lukelookluck/naraebar/backend/drf-yasg공부.md

[drf-yasg](https://medium.com/towncompany-engineering/%EC%B9%9C%EC%A0%88%ED%95%98%EA%B2%8C-django-rest-framework-api-%EB%AC%B8%EC%84%9C-%EC%9E%90%EB%8F%99%ED%99%94%ED%95%98%EA%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)
