lukelookluck/naraebar/requirement.md

- Local

  - 음료 선택 페이지
  - 완료
  - 실패 

- mobile web

  - 사용자 인증
  - 마이페이지 (내 기기 관리 & 즐겨찾기 레시피 확인)
  - 커뮤니티 (레시피 공유)

- 임베디드 

  - 펌프로 액상끌어올리기 (깔떼기통해서 내보내기)
  - 라즈베리파이 포트 수 확인하고
  - 펌프 받으면 제어 잘되는지 확인하기 
  - 펌프 확인해보기 라즈베리파이 포트 수 확인해보기
