lukelookluck/naraebar/릴리즈 노트.md

릴리즈 노트

NaReBar

-  v1.0.0 (Bata)
- 20 Aug 2020

개요

- 나만의 칵테일 레시피로 음료를 만들고 공유할 수 있는 모바일 커뮤니티 및 가정용 칵테일 제조기기 

목적

- 모바일
  - 나만의 레시피를 등록할 수 있다.
  - 등록된 레시피가 커뮤니티에 공유되어, 다른 사람의 레시피도 확인할 수 있다.
  - 커뮤니티에 존재하는 다른 사람의 레시피를 저장하거나 좋아요하고 댓글을 남길 수 있다.
- 디바이스
  - 서버로부터 받아온 레시피 정보를 확인할 수 있다.
  - 해당 레시피 제조 버튼을 눌러서 정량대로 칵테일을 제조할 수 있다. 
  - 세척 버튼을 눌러서 사용 후 잔여물이 남지 않도록 관리할 수 있다. 

연락 정보

- hongsj36@gmail.com

| 작성항목 | 설 명 |
| --- | --- |
| Header | 문서 이름(릴리스 노트 이름), 제품 이름, 버전 번호, 릴리즈 날짜, 참고 날짜, 노트 버전 등 |
| 개요 | 제품 및 변경에 대한 간략한 전반적 개요 |
| 목적 | 릴리스 버전의 새로운 기능목록과 릴리스 노트의 목적에 대한 간략한 개요. 버그 수정 및 새로운 기능 기술. |
| 이슈 요약 | 버그의 간단한 설명 또는 릴리즈 추가 항목 요약 |
| 재현 항목 | 버그 발견에 따른 재현 단계 기술 |
| 수정/개선 내용 | 수정 / 개선의 간단한 설명 기술 |
| 사용자 영향도  | 버전 변경에 따른 최종 사용자 기준의 기능 및 응용 프로그램 상의 영향도 기술 |
| SW 지원 영향도 | 버전 변경에 따른 SW의 지원 프로세스 및 영향도 기술 |
| 노트 | SW 및 HW Install 항목, 제품, 문서를 포함한 업그레이드 항목 메모 |
| 면책 조항 | 회사 및 표준 제품과 관련된 메시지.프리웨어, 불법 복제 방지, 중복 등 참조에 대한 고지 사항 |
| 연락 정보 | 사용자 지원 및 문의 관련한 연락처 정보 |
