lukelookluck/naraebar/예산안.md

## 예산안

| 상품 | 모델명 | 구매링크 | 단가 | 개수(ea) | 합계 | 구매 여부  |
| --- | --- | --- | :--- | --- | --- | --- |
| 다이아프램 펌프 | Micro diaphragm Pump (60W) | [다이아프램 펌프](http://itempage3.auction.co.kr/DetailView.aspx?ItemNo=B505533012&frm3=V2) | 19,200원 ( + 배송비: 2,500원) | 1 | 21,700 | 완료 |
| 릴레이모듈 (8ch) | 8ch Serial Module | [릴레이모듈](http://itempage3.auction.co.kr/DetailView.aspx?ItemNo=B505595214&frm3=V2) | 4,650원 (다이아프램 펌프와 같이 구매 ) | 1 | 4,650 | 완료 |
| 파워서플라이(12V출력) | LRS-150-12 | [파워서플라이](https://smartstore.naver.com/jooyontns/products/498834333) | 28,500원 ( + 배송비: 2,500원) | 1 | 31,000 | 완료 |
| 우레탄 호스 12(외경)*8(내경) 1m | Urethane hose | [pvc호스](https://smartstore.naver.com/saytool/products/3864976067) | 890원 (원터치피팅 pc와 같이 구매) | 1 | 890 | 완료 |
| 우레탄 호스 8(외경)*5(내경) 1m | Urethane hose | [pvc호스](https://smartstore.naver.com/saytool/products/3864976067) | 690원 (원터치피팅 pt와 같이 구매) | 4 | 2,760 | 완료 |
| 원터치피팅 pc: 호스 연결 | PC08-02 | [원터치피팅 pc](https://smartstore.naver.com/saytool/products/3864976067) | 630원 ( + 배송비:  2,500원) | N+1 | 5,650 | 완료 (5개) |
| 원터치피팅 pt: 호스 연결 (t자 연결) | PT08-02 | [원터치 피팅 pt](https://www.devicemart.co.kr/goods/view?no=12284384) | 1,650원 ( + 배송비: 2,500원) | N | 9,100 | 완료 (4개) |
| 원터치피팅 pcf: 유량계 연결 (8) | PCF08-04 | [원터치피팅 pcf8](https://smartstore.naver.com/saytool/products/3864976067) | 2,200원 (원터치피팅 pt와 같이 구매) | 1 | 2,200 | 완료 |
| 원터치피팅 pcf: 유량계 연결 (12) | PCF12-04 | [원터치피팅 pcf12](https://smartstore.naver.com/saytool/products/3864976067) | 2,540원 (원터치피팅 pt와 같이 구매) | 1 | 2,540 | 완료 |
| 모터드라이버 | L298 | [모터드라이버](https://www.devicemart.co.kr/goods/view?no=1278835) | 2,200원 ( + 배송비: 2,500원) | 1 | 4,700 | 완료 |
| 솔레노이드 밸브 | 2Way-솔레노이드(8A) | [솔레노이드 밸브](https://smartstore.naver.com/washcar/products/3884691932) | 5,000원 ( + 배송비: 3,000원 * 2) | N+1 | 8,000+ 23,000 = 31,000 | 완료 (5개) |
| 다이오드 (10개) | 1N4007 | [다이오드](https://www.devicemart.co.kr/goods/view?no=3011)  | 270원 (모터드라이버와 같이 구매) | 1 | 270 | 완료 |
| 레귤레이터 (5V) 모듈 | PWR060010 | [레귤레이터 5V](https://www.devicemart.co.kr/goods/view?no=1384708) | 2,310원 (모터드라이버와 같이 구매) | 1 | 2,310 | 완료 |
| (+추가) 아두이노유량계 | YF-S201C | [유량계](https://smartstore.naver.com/makepcb/products/2075862320) | 8,200원 ( + 배송비: 2,500원) | 1 | 10,700 | 완료 |
| (+선택) LED바 | | 예산 부족 | | 1 | | |
| | | | | | | |
| | | | | 합계 | 120,470 | |

N: 액상 개수 -> 4개 

## 구매 리스트 

- ~~다이아프램 펌프 1개~~ (구매 완료)
- ~~릴레이모듈 (4ch~8ch) : 모터 제어 신호 레벨 변환 역할~~ (구매 완료)
- ~~파워서플라이 (12V출력)~~ (구매 완료)
- ~~pvc호스 12(외경)*8(내경) 1m~~  (구매 완료)
- ~~pvc 호스 8(외경)*5(내경) 4m  (구매 완료)~~
- ~~원터치피팅 pc: 호스 연결 N개~~  (구매 완료)
- ~~원터치피팅 pt: 호스 연결 (t자 연결) N개~~  (구매 완료)
- ~~원터치 피팅 PCF08-04: 유량계 연결~~   (구매 완료)
- ~~원터치 피팅 PCF12-04: 유량계 연결~~   (구매 완료)
- ~~(+선택) 원터치피팅 변환피팅: 12-8 변환피팅 1개~~  (유량계 사용해서 필요 없음)
- ~~모터드라이버 1개~~  (구매 완료)
- ~~솔레노이드 밸브 5개 (당장은 1개만 구매해서 테스트)~~   (구매 완료)
- ~~다이오드 1N4007 * 4~~  (구매 완료)
- ~~레귤레이터 (5V) 모듈~~  (구매 완료)
- ~~수수, 암수 , 암암 세종류 점퍼선~~ (싸피 키트에 포함)
- ~~테프론 테이프~~ (세진선배가 집에서 파밍함)
- ~~(+추가) 아두이노유량계~~   (구매 완료)
- ~~(+선택) LED~~ (예산부족)
- ~~(+추가) 깔떼기 Kitchen Funnel~~  (세진선배가 출력)
- 케이스
