lukelookluck/naraebar/NaReBar 기획서(0723).docx

NaReBar

나만의 레시피 바텐더 기획서

2020. 7. 22(수)

긴급구조 팀

홍세진(팀장), 유건우, 임창묵, 황신실, 이윤민

## 기획서

#### 목차

#### 1. 개요

#### 2. 구상

#### 3. 구현

#### 4. 업무 분배

#### 5. 프로젝트 일정

#### 1. 개요

프로젝트명: 나레바(나만의 레시피 바텐더)

주제: 모바일 웹을 통해 커스텀 레시피를 등록할 수 있는 홈 바텐더 기기 제작

  1-1 . 주제 선정 배경 및 시장 분석

1) 배경

‘코로나바이러스감염증-19’으로 인해 현대인들의 생활 양상에 많은 변화가 일어나고 있다. 2019 년 12월 중국 우한시에서 첫 ‘코로나바이러스감염증-19’ 이 발견된 이후 그 여파는 전 세계로 퍼져나갔다. 대한민국 정부에서는 2020년 2월 23일 감염병 위기 단계를 ‘심각’수준으로 상향했고, WHO(세계보건기구)에서도 2020년 3월 12일 해당 감염병에 대해 최고 경보단계인 펜데믹 (pandemic)을 선언하며 전 세계가 ‘코로나바이러스감염증-19’에 적극 대응하는 모습을 보이고 있다.

‘코로나바이러스감염증-19’은 기침, 재채기 등으로 인한 비말에 의해 감염되는 것으로 알려졌으며, 이에 따라 대한민국 정부에서는 사람 많은 곳 방문 자제와 마스크 착용 등의 행동 수칙을 지정했다. 뿐만 아니라 감성주점, 유흥주점, 노래 연습장 등을 고위험시설로 분류하는 등 ‘코로나바이러스감염증-19’의 확산을 막기 위한 많은 노력이 이루어지고 있다.

2) 국내 현황

‘코로나바이러스감염증-19’으로 인해 감성주점, 유흥주점, 노래 연습장 등이 고위험시설로 분류됨에 따라 집에서 혼자 술을 즐기는 이른바 ’혼술’ 문화가 주류로 자리잡고 있다.

편의점 CU에 따르면 3월의 주류 매출이 전년 대비 20% 가량 증가했고, 이마트24의 3월 와인 매출은 225.6% 신장하는 등 편의점의 주류 매출이 크게 증가했다. 업계 관계자는 “코로나19로 소비자들의 라이프스타일이 변화하면서 편의점에서는 주류 매출이 가장 두드러지게 나타나고 있다”고 언급했다.

LG전자는 이러한 흐름에 맞춰 100만원대의 캡슐형 수제 맥주 제조기를 선보이기도 했다.

코로나19에 홈술족 시장 ‘봄 바람’… 가정용 주류 소비 늘어(뉴데일리경제)

http://biz.newdaily.co.kr/site/data/html/2020/04/21/2020042100102.html

혼술족 위한 캡슐형 수제맥주제조기 나왔다. (한겨레)

http://www.hani.co.kr/arti/economy/consumer/953122.html

3) 기대 효과

칵테일을 즐기는 사람들은 많지만, 레시피를 잘 모르고 실제로 계량하여 제조하는 것이 힘들기 때문에 집에서 즐기기는 쉽지가 않다. 코로나19로 인해 사람들이 붐비는 장소에 가기 힘든 요즘, 집에 머무는 시간이 길어진 사람들은 ‘코로나 블루’라는 우울감을 느끼기도 한다.

그래서 자동으로 칵테일을 만들어주고, 자신만의 레시피를 만들어 공유할 수 있는 홈 바텐더와 모바일 웹 서비스 “나만의 레시피 바텐더(이하 나레바)”를 제안한다.

현재 존재하는 시제품 칵테일 머신은 저장된 레시피로 조합하여 칵테일을 제조한다. “나레바”는 사용자가 직접 커스텀하여 칵테일을 만들 수 있고, 자신만의 레시피를 커뮤니티에 올려 다른 사람들과 공유할 수도 있다. 이를 통해 다양한 칵테일을 맛볼 수 있고, 자신의 개성을 표출할 수 있다.

  1-2. 프로젝트 개발 방향
1) 이용 대상

20~30대 대학생 및 직장인

2) 목표
  A. 여러 술을 섞어서 제공하는 하드웨어 제작
  B. 사용자의 레시피를 입력 받는 모바일 웹 UI제작
  C. 레시피를 받아오고 공유할 수 있는 커뮤니티 서버 제작

#### 2. 구상

#### 1. 기능 명세

#### 1-1. 로컬 UI

#### 1) React로 칵테일 제조 화면 구현

#### 1-1.1.1. 대기화면

#### 1-1.1.2. 레시피 선택 화면

#### 1-1.1.3. 제조 화면

#### 1-1.1.4. 완료 화면

#### 1-2. 모바일 웹 UI

#### 1) React로 나레바 사이트 구현

#### 1-2.1.1. 메인화면

#### 1-2.1.2. 로그인 화면

#### 1-2.1.3. 커뮤니티 화면

#### 1-2.1.3.1. 나만의 레시피 등록 화면

#### 1-2.1.4. 마이페이지 화면

#### 1-2.1.4.1. 동기화 기능

#### 1-3. 서버

#### 1) 웹 서버

#### 1-3.1.1. 커뮤니티 구현

#### 2) 로컬 서버

#### 1-3.2.1. 아두이노 제어

#### 1-3.2.2. 라즈베리파이로 커뮤니티 레시피 데이터 전송

#### 1-4. 임베디드

#### 1) 수신한 데이터에 맞춰 펌프 제어

#### 1-4.1.1. 라즈베리파이와의 시리얼 통신

#### 1-4.1.2. 펌프 제어 회로 구상

#### 1-4.1.3. 펌프 제어 알고리즘 구현

#### 2) 제작 완료 정보 전송

#### 1-4.2.1. 라즈베리파이와의 시리얼 통신

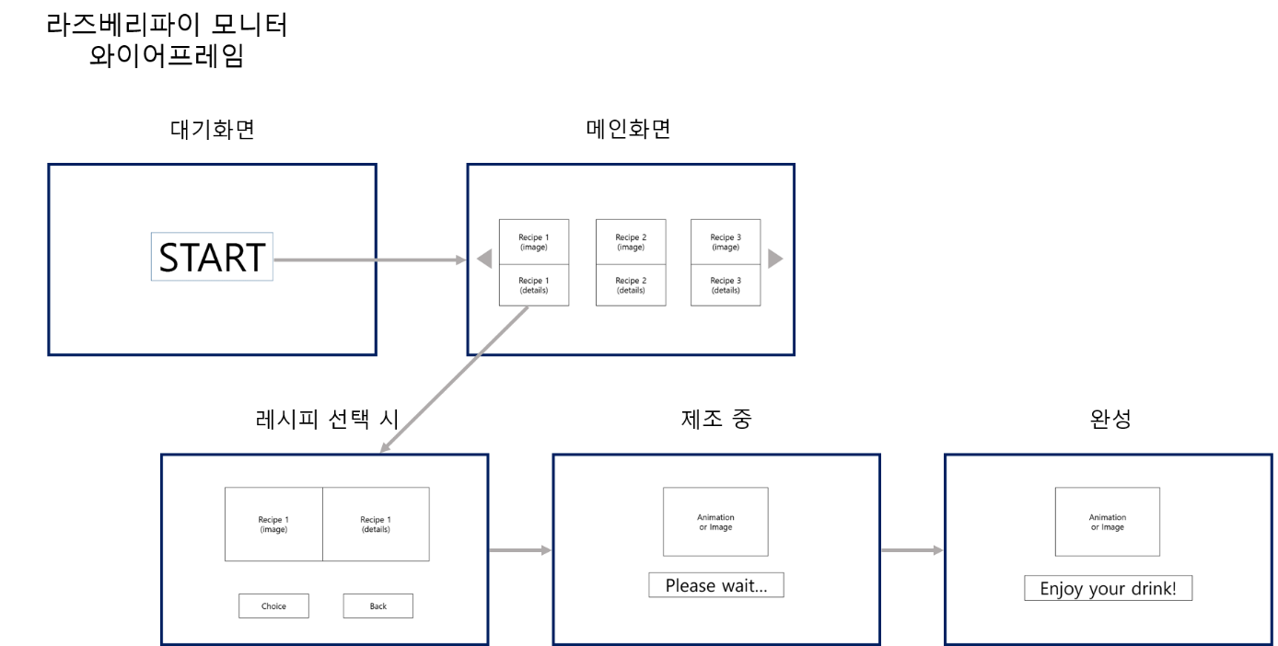
[picture p7: figure]

#### 2. 와이어프레임

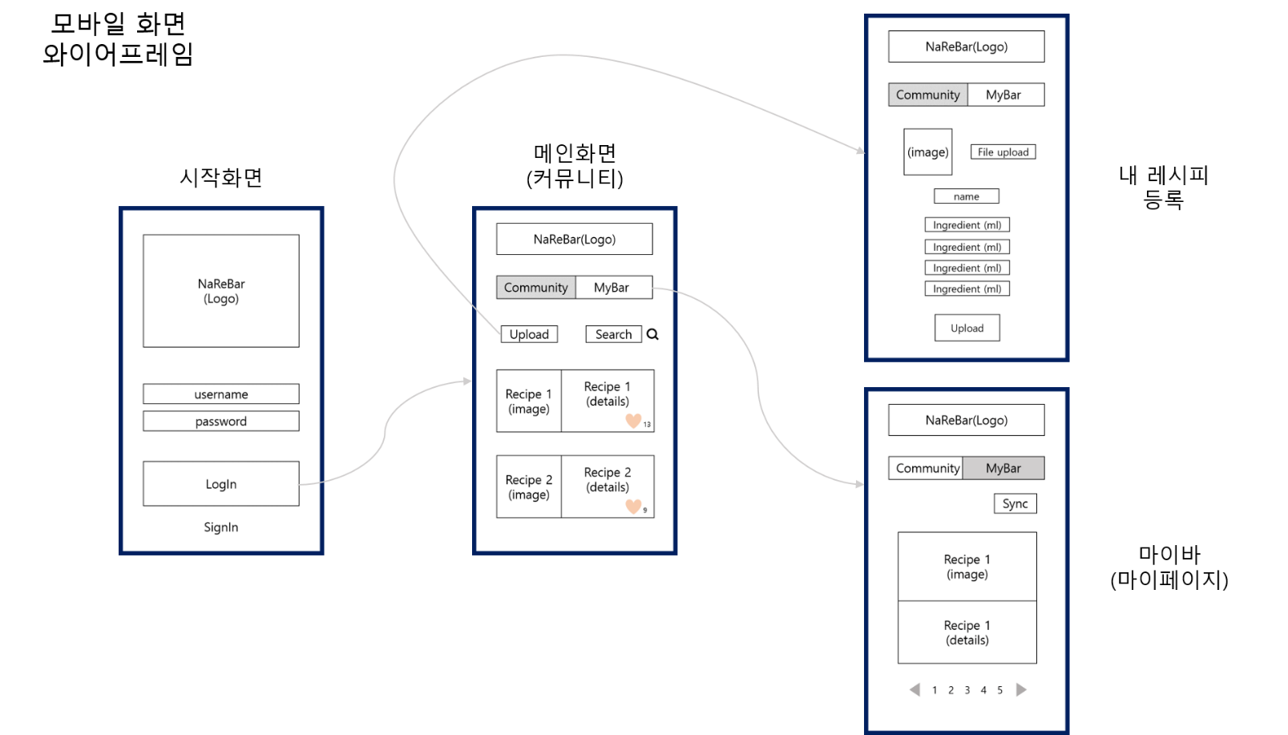
[picture p8: figure]

#### 3. API // 미완성

요청url | 데이터 형식 | 비고

#### 4. 개발 언어 및 활용 장비

항목 | 적용대상 | 비고
React | 프론트엔드
Raspberry pi LCD | 프론트엔드 | 1개 제공
Django | 백엔드
MariaDB | 백엔드
AWS | 백엔드
EC2 | 백엔드
Raspberry pi 4 | 프론트엔드, 백엔드, 임베디드 | 1개 제공
Arduino | 임베디드 | 1개 제공
Pump (DC Motor) | 임베디드 | 자비로 구매
Relay Module | 임베디드 | 자비로 구매

#### 5. 예산

항목 | 상세 | 단가 | 수량 (ea) | 비용
펌프(모터) 모델명: | 역할: 칵테일 재료를 끌어올림 링크: 펌프 (https://smartstore.naver.com/ic11401/products/697431761) | 8400 | 4 | 33600
모터드라이버 모델명: L293D | 역할: 모터 구동을 위한 드라이버 링크: 모터 드라이버 (https://smartstore.naver.com/ic11401/products/560846516) | 2040 | 1 | 2040
다이오드 모델명: 1N4007 | 역할: 역전압 보호회로 구성 링크: 다이오드 (https://www.devicemart.co.kr/goods/view?no=3011) | 25 | 8 | 200
파워서플라이 모델명: | 역할: 12V전원 공급 링크: 파워서플라이 (https://smartstore.naver.com/jooyontns/products/498258307) | 24500 | 1 | 24500
레귤레이터 모델명: LM2576T-5V | 역할: 12V전원 -> 5V전원으로 변환 링크: 레귤레이터 (https://www.devicemart.co.kr/goods/view?no=1058242) | 800 | 1 | 800
PVC 호스 | 역할: 칵테일 재료 이동 통로 링크: PVC호스 (펌프 선택구매란에 있음) (https://smartstore.naver.com/ic11401/products/697431761) | 1000 | 3 | 3000
점퍼선 (수-수,암-수,암-암) | 역할: 브레드보드 회로 결선 링크: 점프선(M/M) (https://www.devicemart.co.kr/goods/view?no=1321196), 점프선(F/M) (https://www.devicemart.co.kr/goods/view?no=1321195), 점프선(F/F) (https://www.devicemart.co.kr/goods/view?no=1321192) (종류별로 한묶음씩) | 850 | 3 | 2550
기타 | 배송료 (협신전자, 디바이스마트, 주연티앤에스) | 2500 | 3 | 7500
합계 | | | | 74190원

#### 3. 구현

#### 3-1. 기술 상세 명세 // 미완성

#### 1) 모바일 웹 UI

#### A. 메인 화면

#### 2) 로컬 UI

#### 3) 서버

#### 4) 임베디드

#### - 회로구성

#### - 부품 선정

#### - 모터 (펌프) : 액상을 펌핑하는 역할

#### - 모터드라이버 : 모터 구동을 위한 드라이버

#### - 다이오드 : 모터 보호회로에 사용

#### - 파워서플라이 (12V출력) : 12V전원 공급

#### - 레귤레이터 (5V) : 12V전원 -> 5V전원으로 변환

#### - pvc호스 : 칵테일 재료 이동 통로

#### - 점퍼선 (수-수, 암-수, 암-암) : 브레드보드 회로 결선

#### - 모터 기준으로 전력량 계산하여 적절한 소자를 구매할 것

#### - 회로도 구상

#### - 전원부

#### - 12V전원을 모터에 공급

#### - 레귤레이터를 통해 5V로 변환된 전원을 라즈베리파이와 아두이노에 각각 공급

#### - 시리얼 통신

#### - 라즈베리파이의 txd와 rxd와 아두이노의 rxd, txd를 연결

#### - 모터

#### - GPIO와 모터드라이버를 통해 모터를 제어할 수 있도록 구성

#### - 모터드라이버와 모터 사이에 다이오드를 통한 보호회로 구성

#### - 회로 결선

#### - 브레드 보드 위에 회도로 대로 결선

#### - 아두이노

#### - 펌프

#### - 모터 구동

#### - GPIO포트 및 모터드라이버를 이용해 모터 구동 코드 개발

#### - 펌프 정확도 확인

#### - 시리얼통신

#### - 컴퓨터와의 시리얼 통신 구현 코드 개발

#### - 컴퓨터와의 연결을 끊고 라즈베리파이와의 시리얼 통신 구현

#### - 라즈베리파이

#### - 파이썬으로 아두이노와의 시리얼 통신 구현

#### - 라즈베리 파이 시리얼포트 활성화

#### - 파이썬 씨리얼모듈 import하여 시리얼통신 코드 구현

#### - 아두이노와의 시리얼 통신 테스트

#### - 하드웨어 제작

#### - 펌프를 추가하여 시제품 제작

#### - 케이스 제작

#### - LCD 부착

#### 3-2. 구성도

#### - 전체 구상

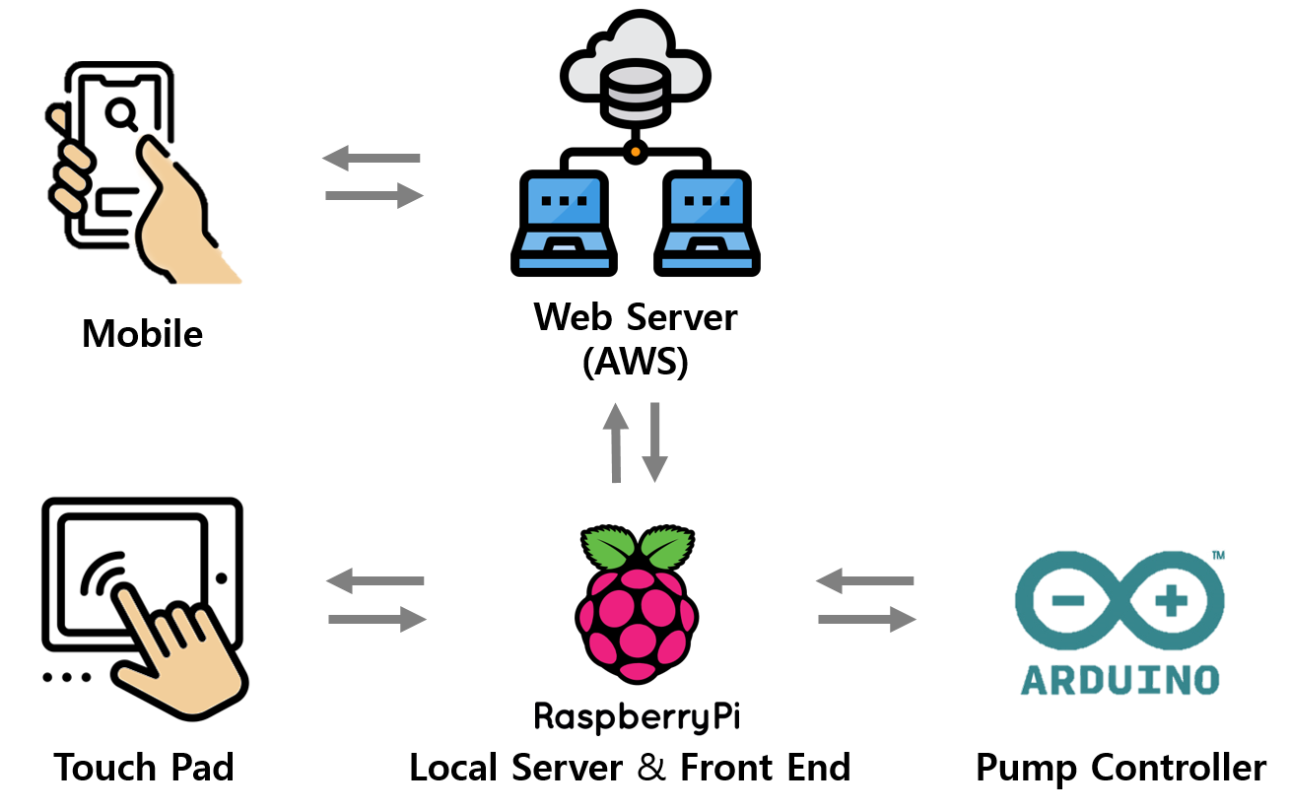
[picture p9: figure]

#### - 펌프 & 밸브

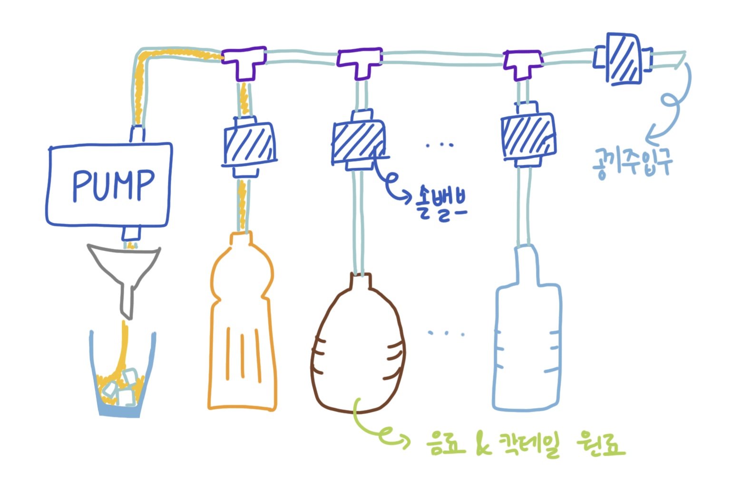
[picture p10: figure]

#### 3-3. 회로도

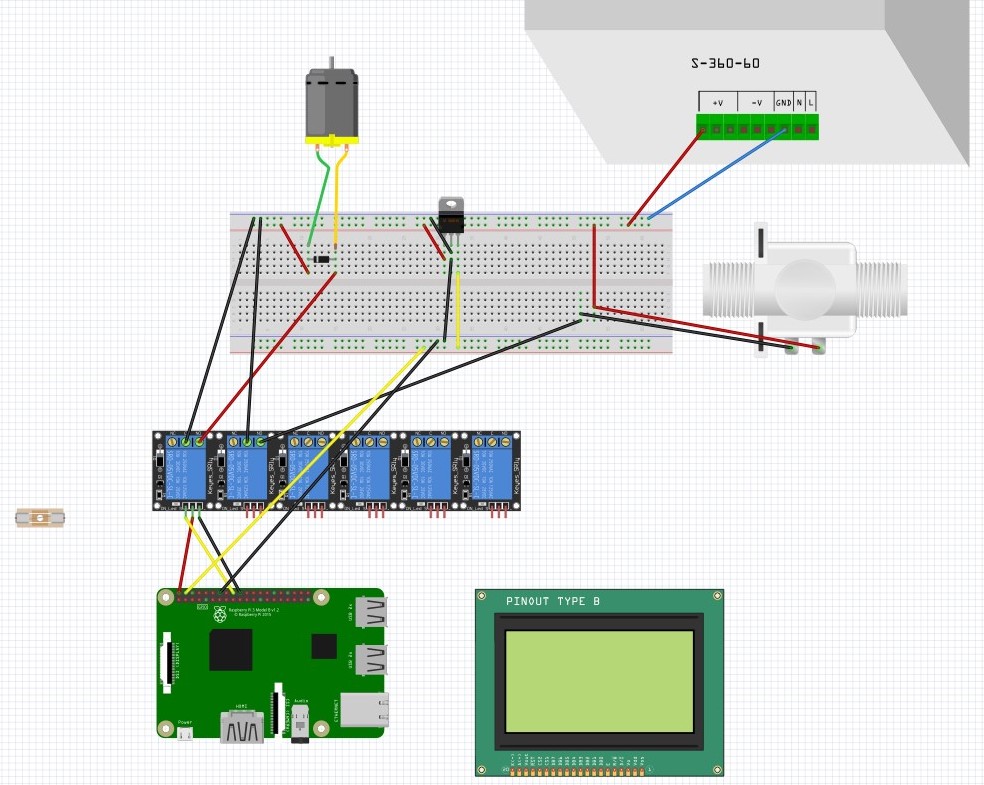
[picture p11: figure]

4. 업무 분배

- 홍세진(팀장): 백엔드, 임베디드 (라즈베리파이, 구매)

- 유건우: 프론트엔드

- 임창묵: 프론트엔드

- 황신실: 임베디드 (아두이노, 주변 회로설계)

- 이윤민: 프론트엔드

#### 5. 프로젝트 일정

#### sub_pjt2

#### - 1주차

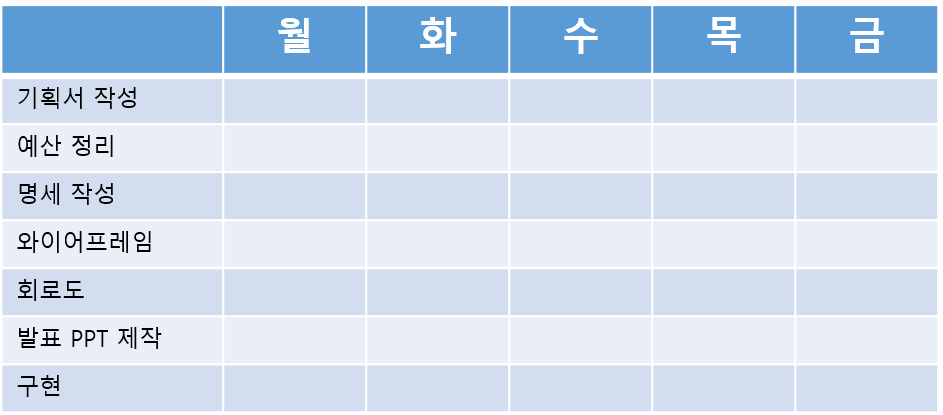
[picture p12: figure]

#### - 2주차

#### sub_pjt3

#### - 1주차

#### - 2주차

#### - 2주차

#### - 임베디드: 부품 조작 및 프로토타입 제작 완료 ( 모터 및 밸브 구동 )

#### - 프론트엔드: 와이어프레임에 맞게 로컬 및 웹 화면 구성

#### - 백엔드: 로컬 서버 구현

#### sub_pjt3 // 미완성

#### - 1주차

#### - 2주차

#### - 3주차
