lukelookluck/naraebar/나레바_로컬_화면_구상중_0721_.pptx

대기화면

START

## Slide 2

메인화면

Recipe 1
(image)

Recipe 2
(image)

Recipe 3
(image)

Recipe 1
(details)

Recipe 2
(details)

Recipe 3
(details)

## Slide 3

칵테일 선택

Recipe 1
(image)

Recipe 1
(details)

Choice

Back

## Slide 4

선택 후

Animation
or Image

Please wait…

## Slide 5

완성

Enjoy your drink!

Animation
or Image

## Slide 6

라즈베리파이 모니터
와이어프레임

대기화면

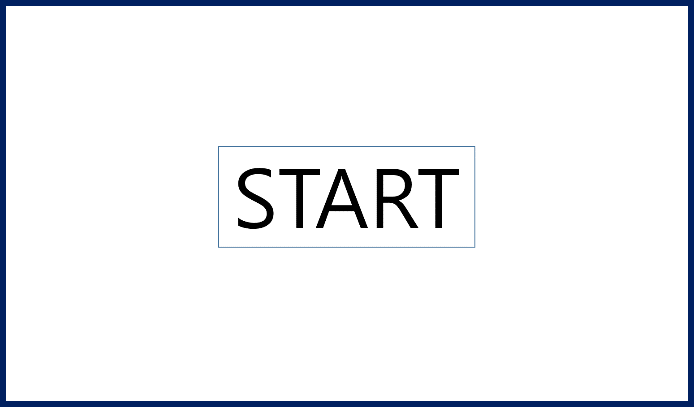
[picture p13: figure]

메인화면

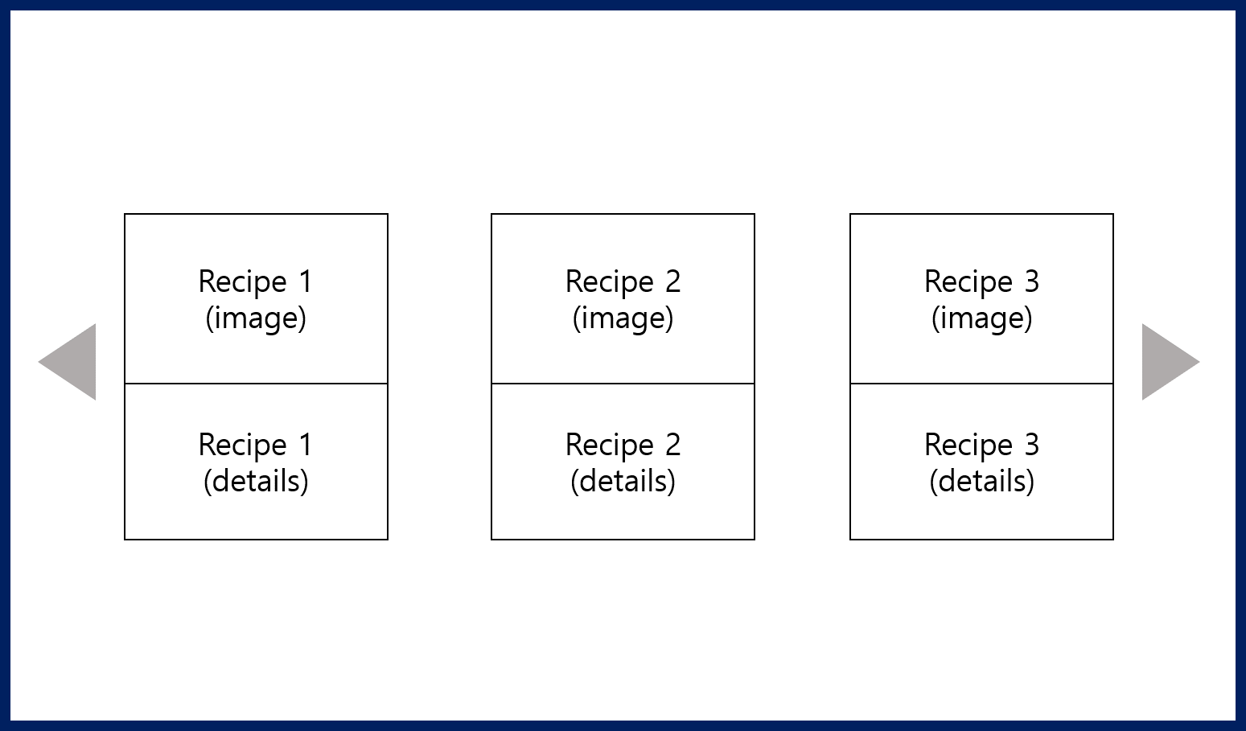
[picture p14: figure]

레시피 선택 시

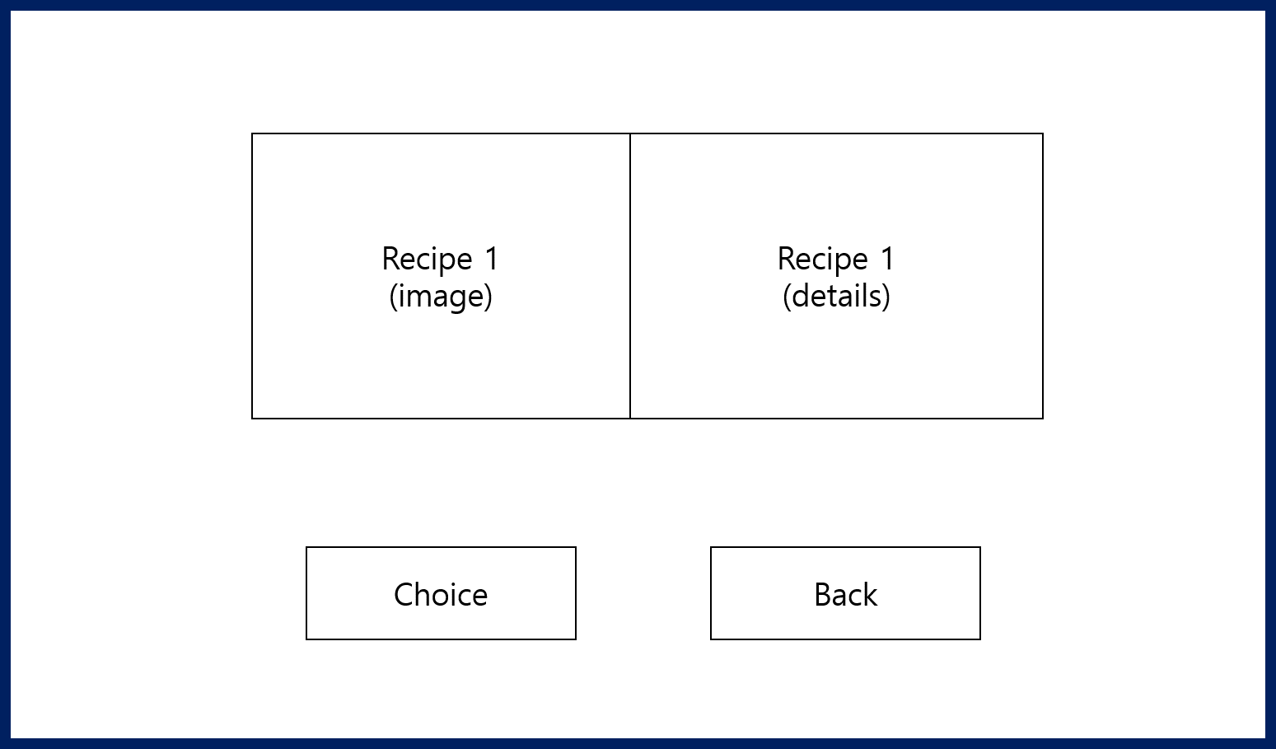
[picture p15: figure]

제조 중

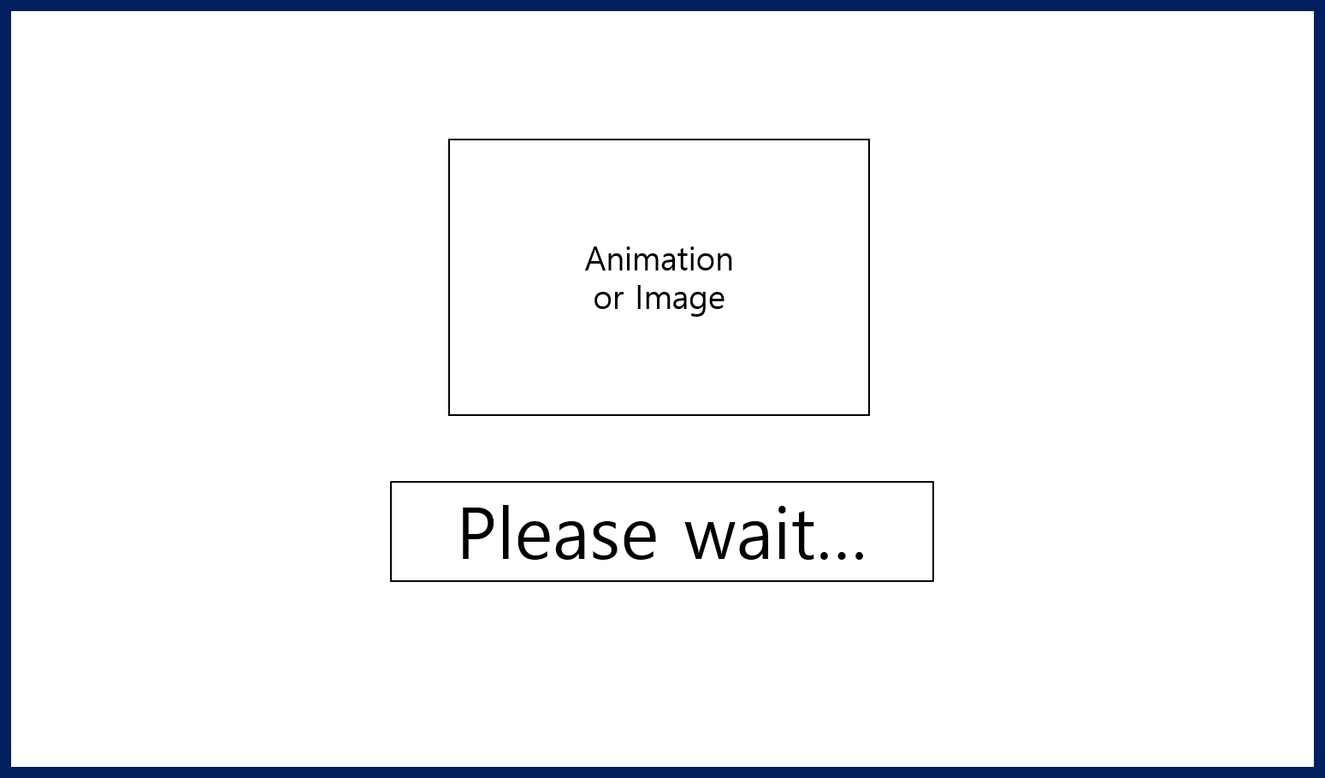
[picture p16: figure]

완성

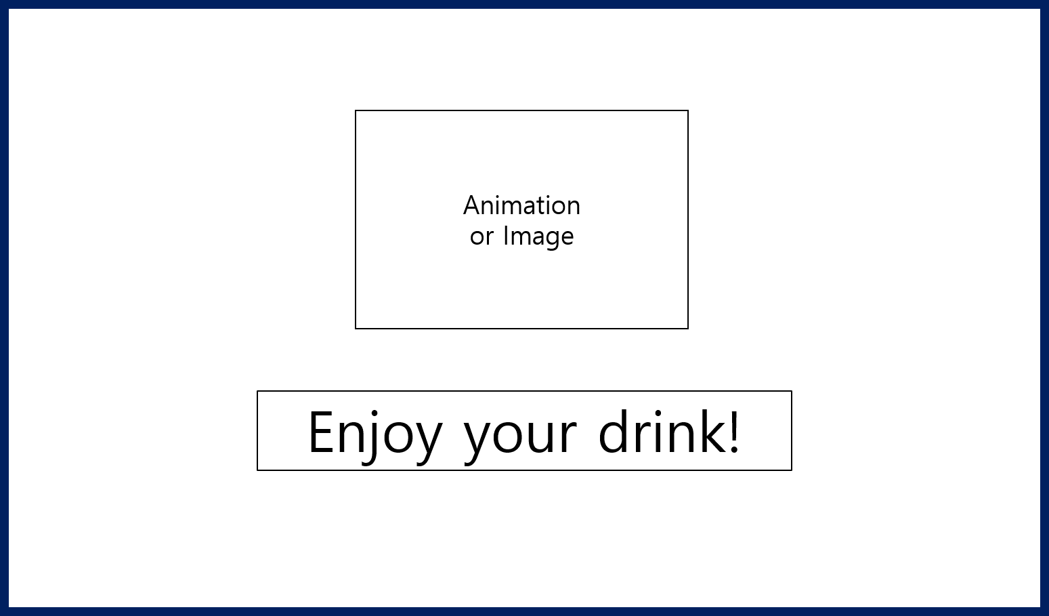
[picture p17: figure]
