lukelookluck/naraebar/나레바_모바일_화면_구상중_0721_.pptx

메인화면

NaReBar
(Logo)

username

password

LogIn

SignIn

## Slide 2

로그인후
메인화면

NaReBar(Logo)

MyBar

Community

Upload

Recipe 1
(image)

Recipe 2
(image)

Search

Recipe 1
(details)

Recipe 2
(details)

13

9

## Slide 3

로그인후
Upload 클릭 시

NaReBar(Logo)

MyBar

Community

(image)

File upload

Ingredient (ml)

name

Ingredient (ml)

Ingredient (ml)

Ingredient (ml)

Upload

## Slide 4

로그인후
MyBar

NaReBar(Logo)

MyBar

Community

Sync

Recipe 1
(image)

Recipe 1
(details)

1 2 3 4 5
