lukelookluck/naraebar/backend/web/media/2020/08/15/b2d03e59-f0f3-4398-b04f-a8fa04100514.jpg

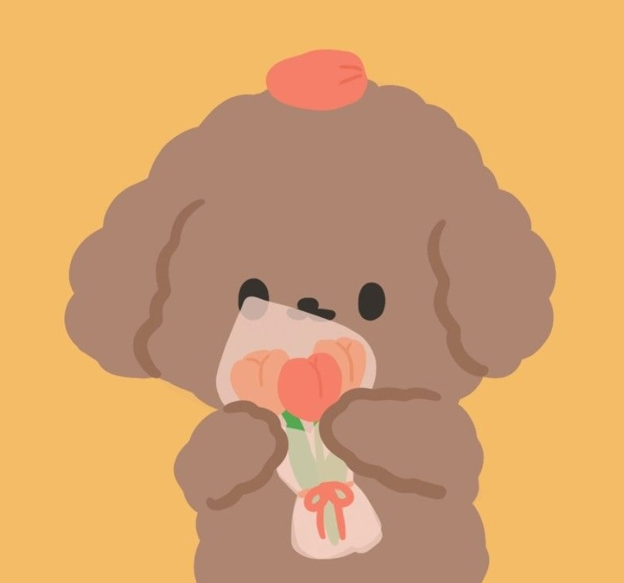
backend/web/media/2020/08/15/b2d03e59-f0f3-4398-b04f-a8fa04100514.jpg
