lukelookluck/naraebar/backend/web/media/2020/08/20/a615ee56-f529-42a6-a362-80225d327c8a.jpg

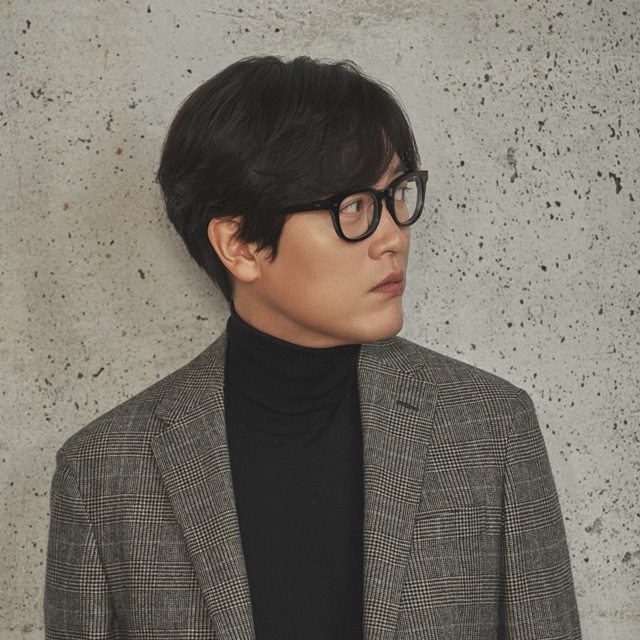
backend/web/media/2020/08/20/a615ee56-f529-42a6-a362-80225d327c8a.jpg
