lukelookluck/naraebar/backend/web/media/2020/08/20/c9f65255-5e9a-4d70-8621-e818bfa2c31f.jpg

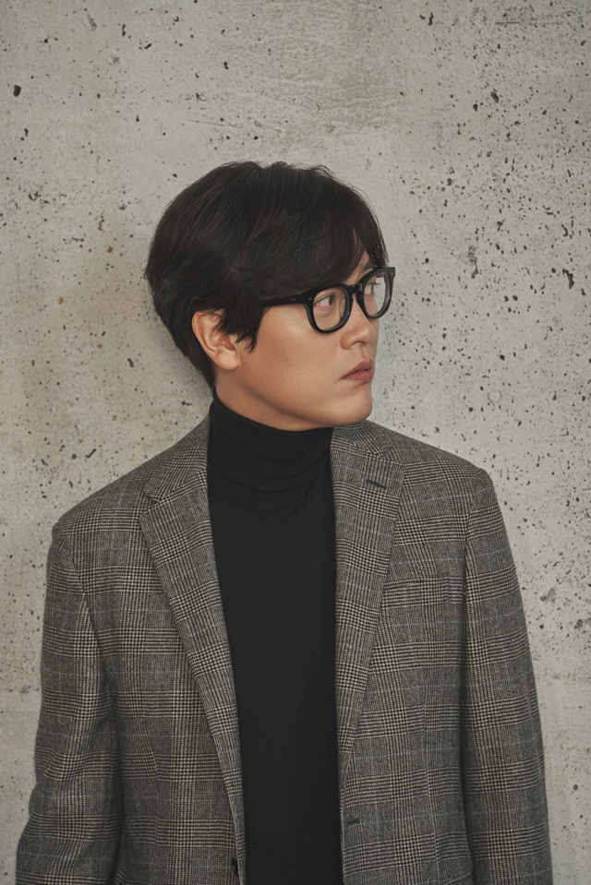
backend/web/media/2020/08/20/c9f65255-5e9a-4d70-8621-e818bfa2c31f.jpg
