lukelookluck/naraebar/images/FastPwmCom.JPG

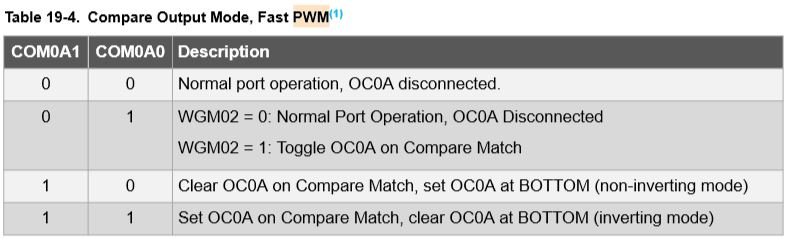
images/FastPwmCom.JPG
