lukelookluck/naraebar/images/idea1.jpg

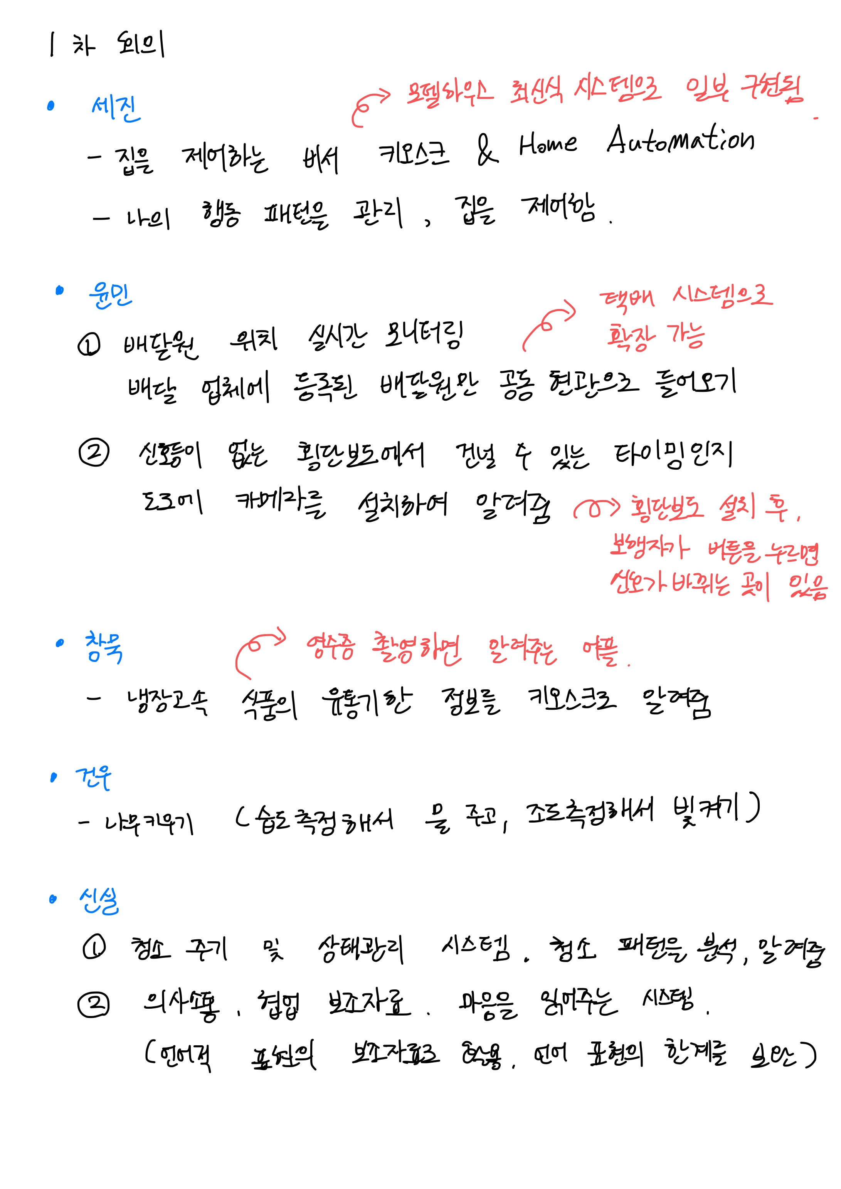
images/idea1.jpg
