lukelookluck/naraebar/images/idea2.jpg

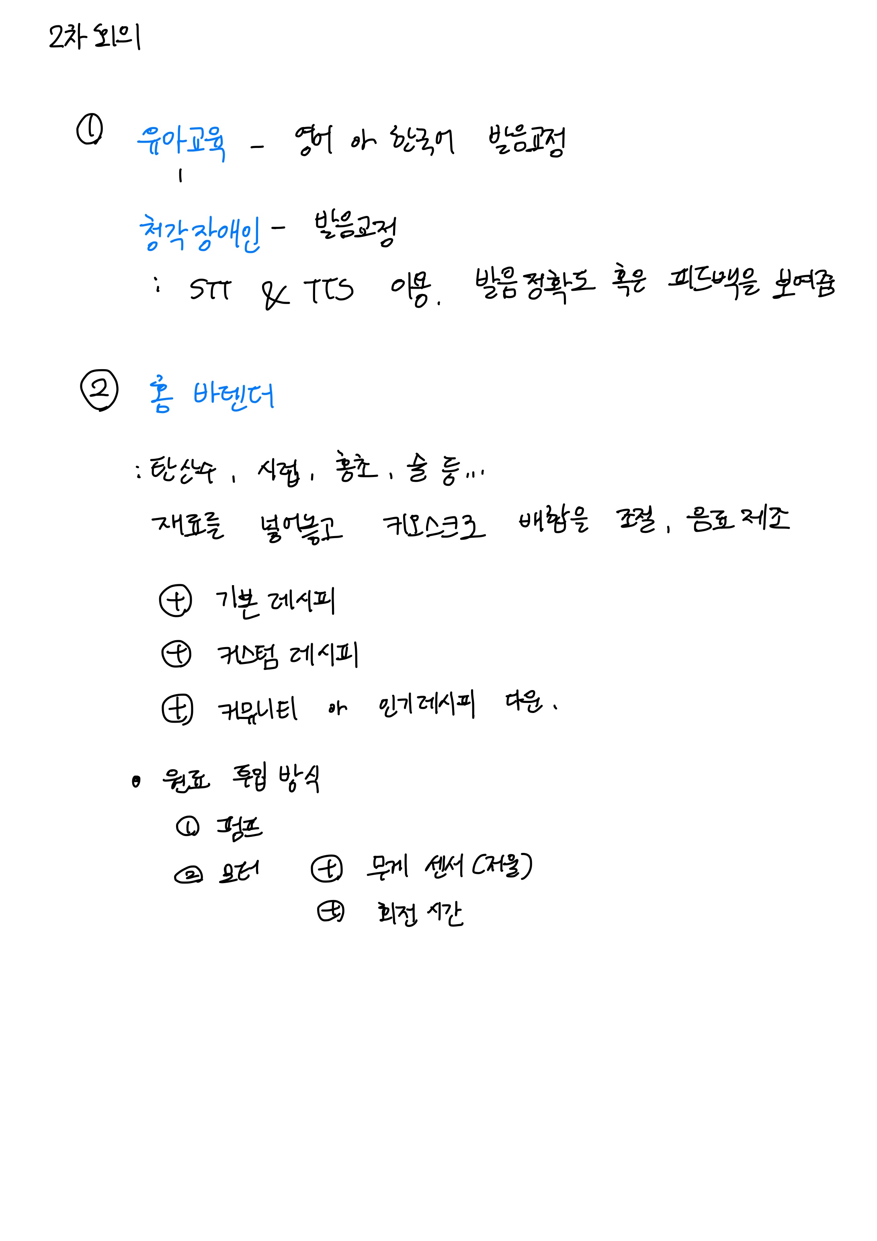
images/idea2.jpg
