lukelookluck/naraebar/images/idea3.jpg

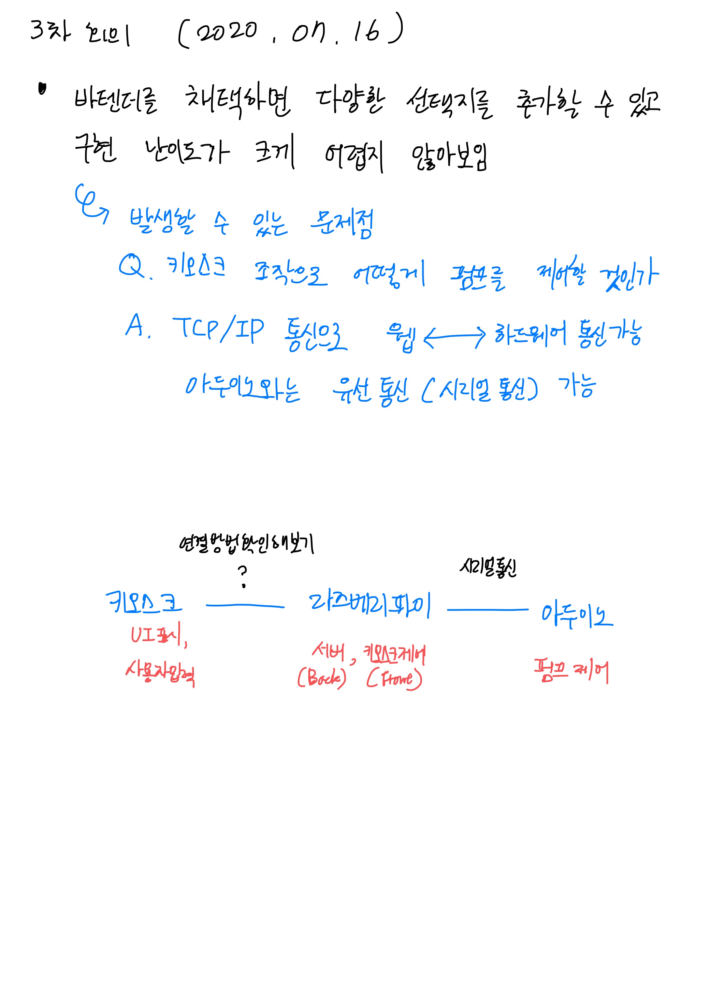
images/idea3.jpg
