lukelookluck/naraebar/images/idea.JPG

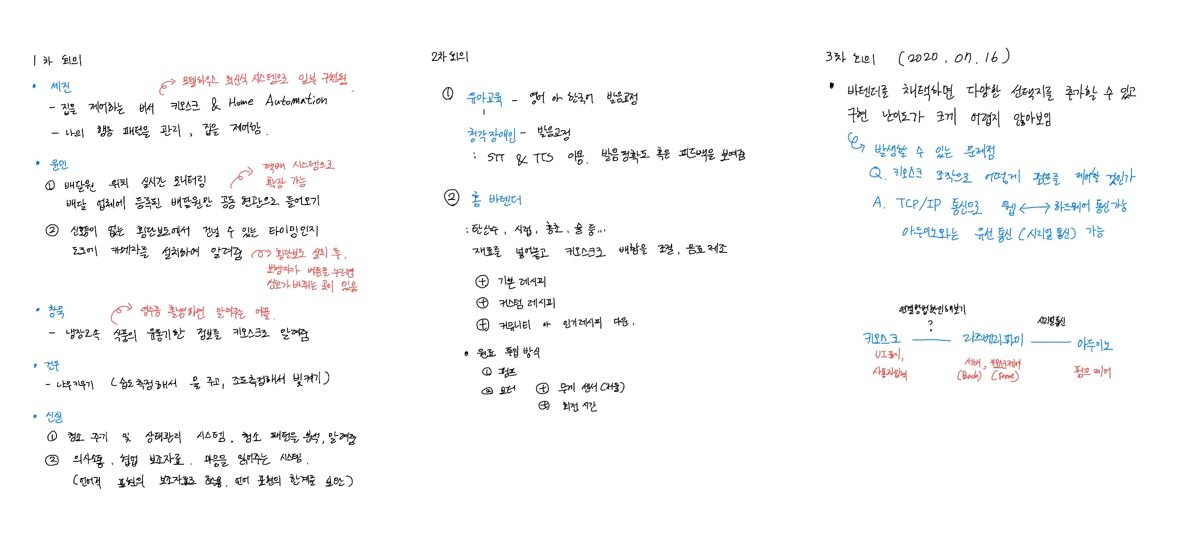
images/idea.JPG
