lukelookluck/naraebar/images/L298_Mark.jpg

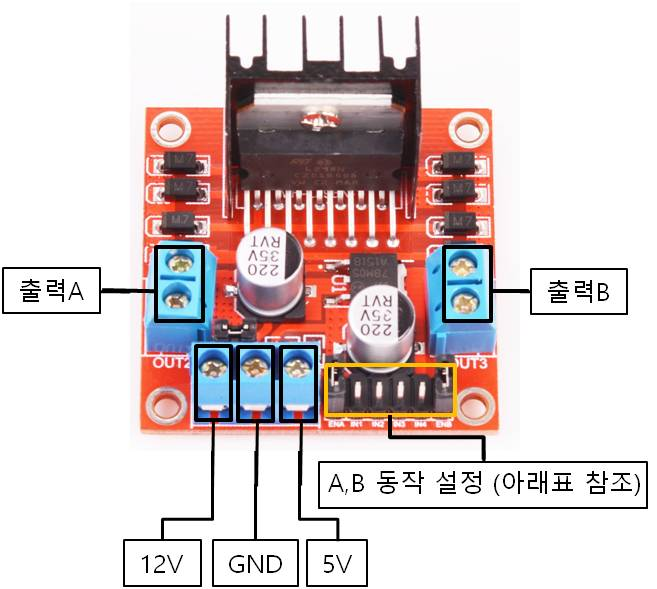
images/L298_Mark.jpg
