lukelookluck/naraebar/images/L298_Table.png

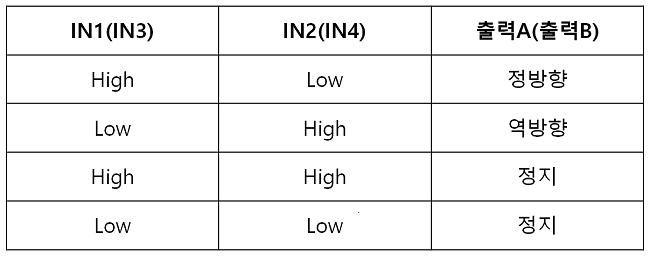
images/L298_Table.png
