lukelookluck/naraebar/images/pump_and_solenoid_velve.png

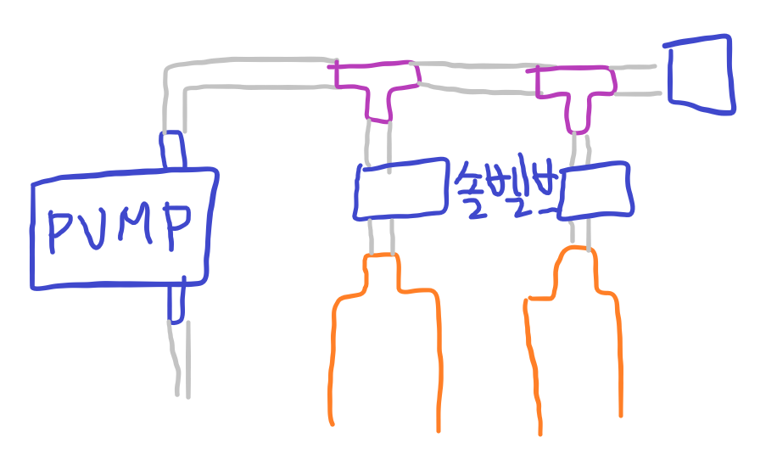
images/pump_and_solenoid_velve.png
