lukelookluck/naraebar/images/wire1.jpg

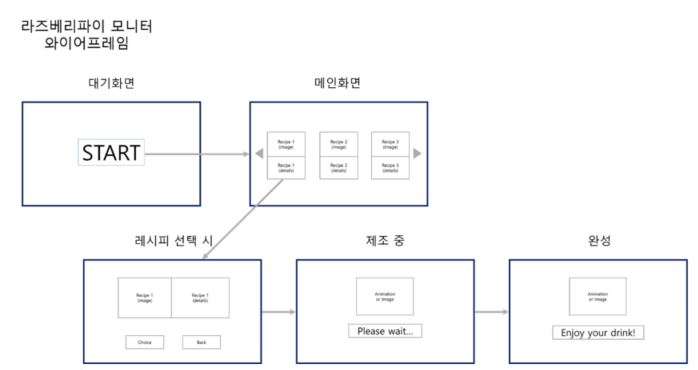
images/wire1.jpg
