lukelookluck/naraebar/images/wire2.JPG

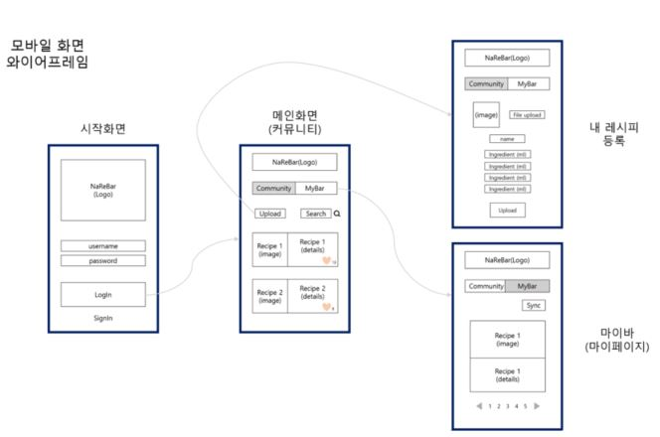
images/wire2.JPG
