lukelookluck/naraebar/images/구성.png

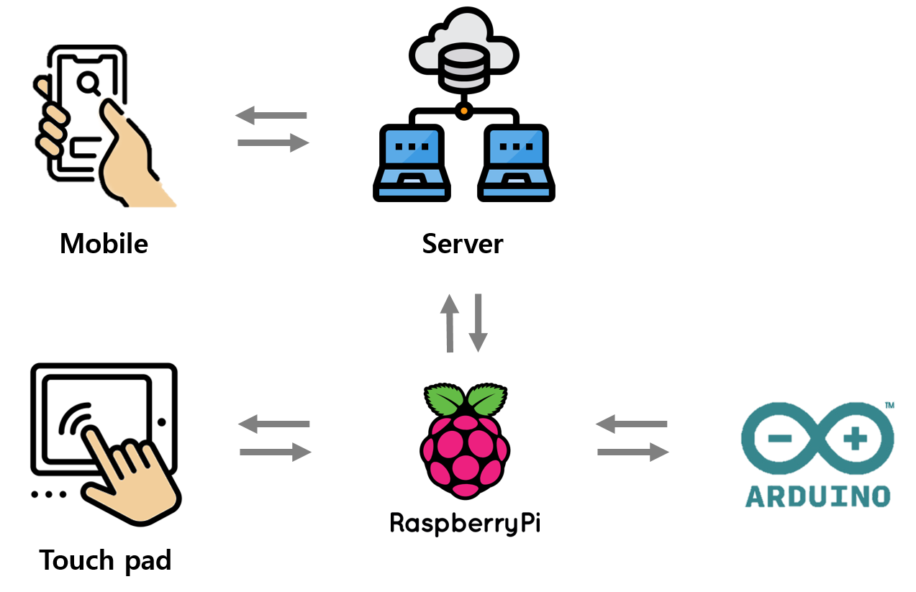
images/구성.png
