lukelookluck/naraebar/images/라즈베리파이 회로도.jpg

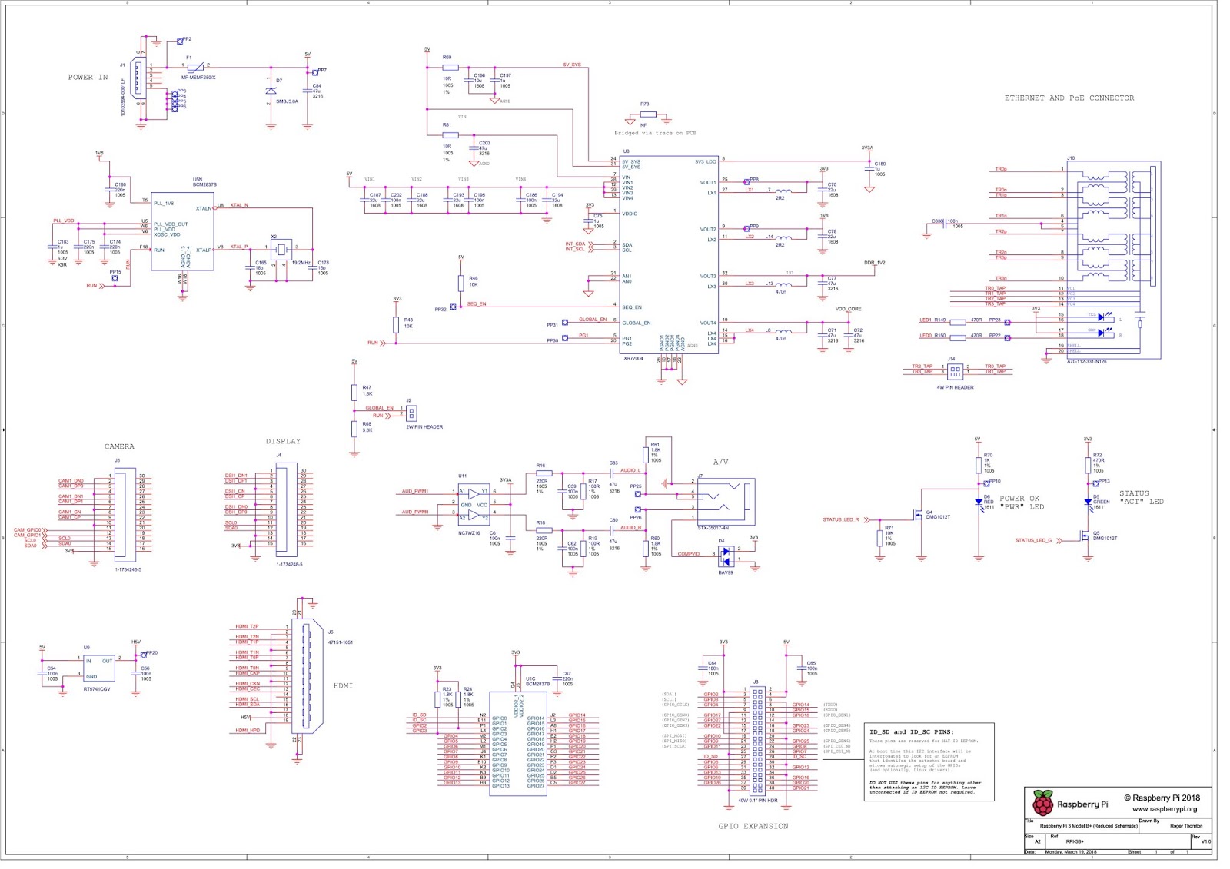
images/라즈베리파이 회로도.jpg
