lukelookluck/naraebar/(list of files, cad)

Other CAD files:
embeded/NAREBAR V2.f3d
