lukelookluck/naraebar/backend/web/recipe/serializers.py

from rest_framework import serializers
from . import models


class RecipeSerializer(serializers.ModelSerializer):
    class Meta:
        model = models.Recipe
        fields = '__all__'


class IngredientSerializer(serializers.ModelSerializer):
    class Meta:
        model = models.Ingredient
        fields = '__all__'


class IngredientCategorySerializer(serializers.ModelSerializer):
    class Meta:
        model = models.IngredientCategory
        fields = '__all__'
