lukelookluck/naraebar/(commit log)

2020-07-21 Upload "나레바 로컬 화면 구상중(0721).pptx"
2020-07-22 S03P12D209-32 update 명세서
2020-07-22 S03P12D209-32 update 명세서 0722
2020-07-22 design temporary circuit
2020-07-23 행아웃하면서 폴더 및 파일 다듬기
2020-07-23 added 구조 file
2020-07-23 updated NaReBar 기획서(0723) file
2020-07-23 update 시작, 끝 화면
2020-07-23 added 예산안file
2020-07-24 S03P12D209-19 모바일 웹ui 프로젝트 생성
2020-07-24 modified 예산안 file
2020-07-27 S03P12D209-19 폴더, 파일 기본 틀 생성
2020-07-27 S03P12D209-19 시작화면 구성
2020-07-27 WEB_FRONTEND | add MyBar prototype
2020-07-27 S03P12D209-19 덤프파일로 로그인 구현중
2020-07-27 add material-ui/icons module
2020-07-28 S03P12D209-19 메인화면에 Mui, styled component 적용
2020-07-28 S03P12D209-49 헤더와 네브탭 구현중
2020-07-28 탭 수정중
2020-07-29 update 여러 페이지
2020-07-30 S03P12D209-49 헤더와 네비탭 구현git add *
2020-07-30 회원가입 화면 구현중
2020-07-30 글작성화면 구현 중
2020-07-31 updated 글쓰기
2020-07-31 selectcocktail의 css파일 jsx로 파일 변경
2020-07-31 글쓰기 업로드 이미지 미리보기 구현 80%
2020-08-03 한글패치
2020-08-04 S03P13D209-32 웹 폰트 적용
2020-08-04 S03P13D209-32 모바일웹에 웹 폰트 적용
2020-08-04 S03P13D209-20 한글패치 및 디자인 통일 중
2020-08-04 S03P13D209-20 수정중
2020-08-04 S03P13D209-20 왜 줄바꿈이 안되는걸까
2020-08-05 S03P13D209-20 줄바꿈, 웹폰트 적용중
2020-08-05 S03P13D209-20 통일 중
2020-08-06 S03P13D209-19 캐로셀 수정
2020-08-06 S03P13D209 캐로셀 완성, 선택된 화면 수정중
2020-08-06 S03P13D209-49 community 백앤드 개발
2020-08-06 added circuit.jpg file
2020-08-06 S03P13D209-51 댓글 더보기랑 댓글 작성화면60% 구현
2020-08-06 S03P13D209-19 선택화면 수정중
2020-08-06 S03P13D209-19 선택 화면 update
2020-08-06 S03P13D209-19 흰 바탕으로 완성
2020-08-07 S03P13D209-20 MyBar 카드 수정중
2020-08-07 S03P13D209-20 레시피 삭제버튼 생성
2020-08-07 페이지네이션 뭘까
2020-08-07 DJANGO | web/recipe 아직 하는 중...
2020-08-07 Paginaion 해결
2020-08-07 S03P13D209-58 댓댓글 표시 구현 생성은 아직
2020-08-08 댓댓글 불러오기 구현
2020-08-10 답글 보이기 구현
2020-08-10 댓댓글 불러오기 구현 완료
2020-08-10 S03P13D209-66 에러페이지 생성
2020-08-10 S03P13D209-68 세척중 화면 제작
2020-08-10 화면 보면서 위치 조절
2020-08-10 S03P13D209-64 게시글 생성 구현 완료, 댓글 생성만 구현 삭제는 아직
2020-08-10 S03P13D209-64 게시글과 댓글 생성은 구현, 수정/삭제는 아직
2020-08-11 used timer/counter0
2020-08-11 S03P13D209-59 좋아요 기능 구현 완료, 현재 유저 정보 연동은 내일
2020-08-11 S03P13D209-59 좋아요 기능 구현 완료, 현재 유저 정보 연동은 내일(백앤드)
2020-08-11 웹 css 수정
2020-08-11 narebar 3d model
    [NAREBAR V2.f3d]
2020-08-11 S03P13D209-59 댓글 좋아요 기능 구현 완료, 현재 유저 정보 연동은 내일
2020-08-12 update from raspberrypi
2020-08-12 S03P13D209-65 게시글 수정/삭제 구현 완료
    [serializers.py, urls.py, views.py]
2020-08-12 아직 네트워크 에러남
2020-08-13 S03P13D209-80 프록시 수정으로 성공
2020-08-13 이미지 뜬다!!!
2020-08-13 S03P13D209-81 서버에서 받아와서 출력!
2020-08-13 총맞고싶다
2020-08-14 결국 깃 클론 다시 받아서 코드 옮기는 중
2020-08-14 로켓배송
2020-08-14 S03P13D209-85 마이바 프론트 수정중
2020-08-15 머지 전 커밋
2020-08-17 modified flowmeter code
2020-08-17 DJANGO | local bartender random 구현
2020-08-19 이미지 된다ㅠㅠ
2020-08-19 init make_cocktail, 시리얼 통신
2020-08-19 왜 셋보틀 화면에는 사진이 안뜨냐고
2020-08-19 윤민아아
2020-08-19 update local serial and 'Attempting to use a port that is not open'Error
    [urls.py, views.py]
2020-08-19 슬라이드 가능git add .git add .!
2020-08-19 글쓰기 버튼 편식 완료
2020-08-19 외 않된대?
2020-08-20 디자인 재수정
2020-08-20 embeded.ino file 완성
2020-08-20 디자인 재수정 2.0
2020-08-20 주석 정리
2020-08-20 커뮤니티 완료
